erikwiskman/MoreBac/(commit log)

2017-03-23 Add files via upload
    CAD of experiment
2017-06-15 Create CAD
2017-06-15 Create CAD FOLDER
2017-06-18 CAD FOLDER
